CytronTechnologies/MAKER-UNO-X/Schematic and PCB/Gerber Files/MAKER-UNO-X.TXT

%
M48
M72
T01C0.01000
T02C0.01500
T03C0.01575
T04C0.02000
T05C0.03150
T06C0.03200
T07C0.03543
T08C0.03937
T09C0.11811
%
T01
X46500Y109500
X49500Y109500
X52500Y109500
X52500Y115500
X49500Y115500
X46500Y115500
X38500Y119500
X35500Y119500
X32500Y119500
X32500Y125500
X35500Y125500
X38500Y125500
X46500Y129500
X49500Y129500
X52500Y129500
X52500Y135500
X49500Y135500
X46500Y135500
X38500Y139500
X35500Y139500
X32500Y139500
X32500Y145500
X35500Y145500
X38500Y145500
X46500Y149500
X49500Y149500
X52500Y149500
X52500Y155500
X49500Y155500
X46500Y155500
X38500Y159500
X35500Y159500
X32500Y159500
X32500Y165500
X35500Y165500
X38500Y165500
X46500Y179500
X49500Y179500
X52500Y179500
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
