CytronTechnologies/MAKER-UNO-X/Schematic and PCB/Schematic - PDF/MAKER-UNO-X.pdf

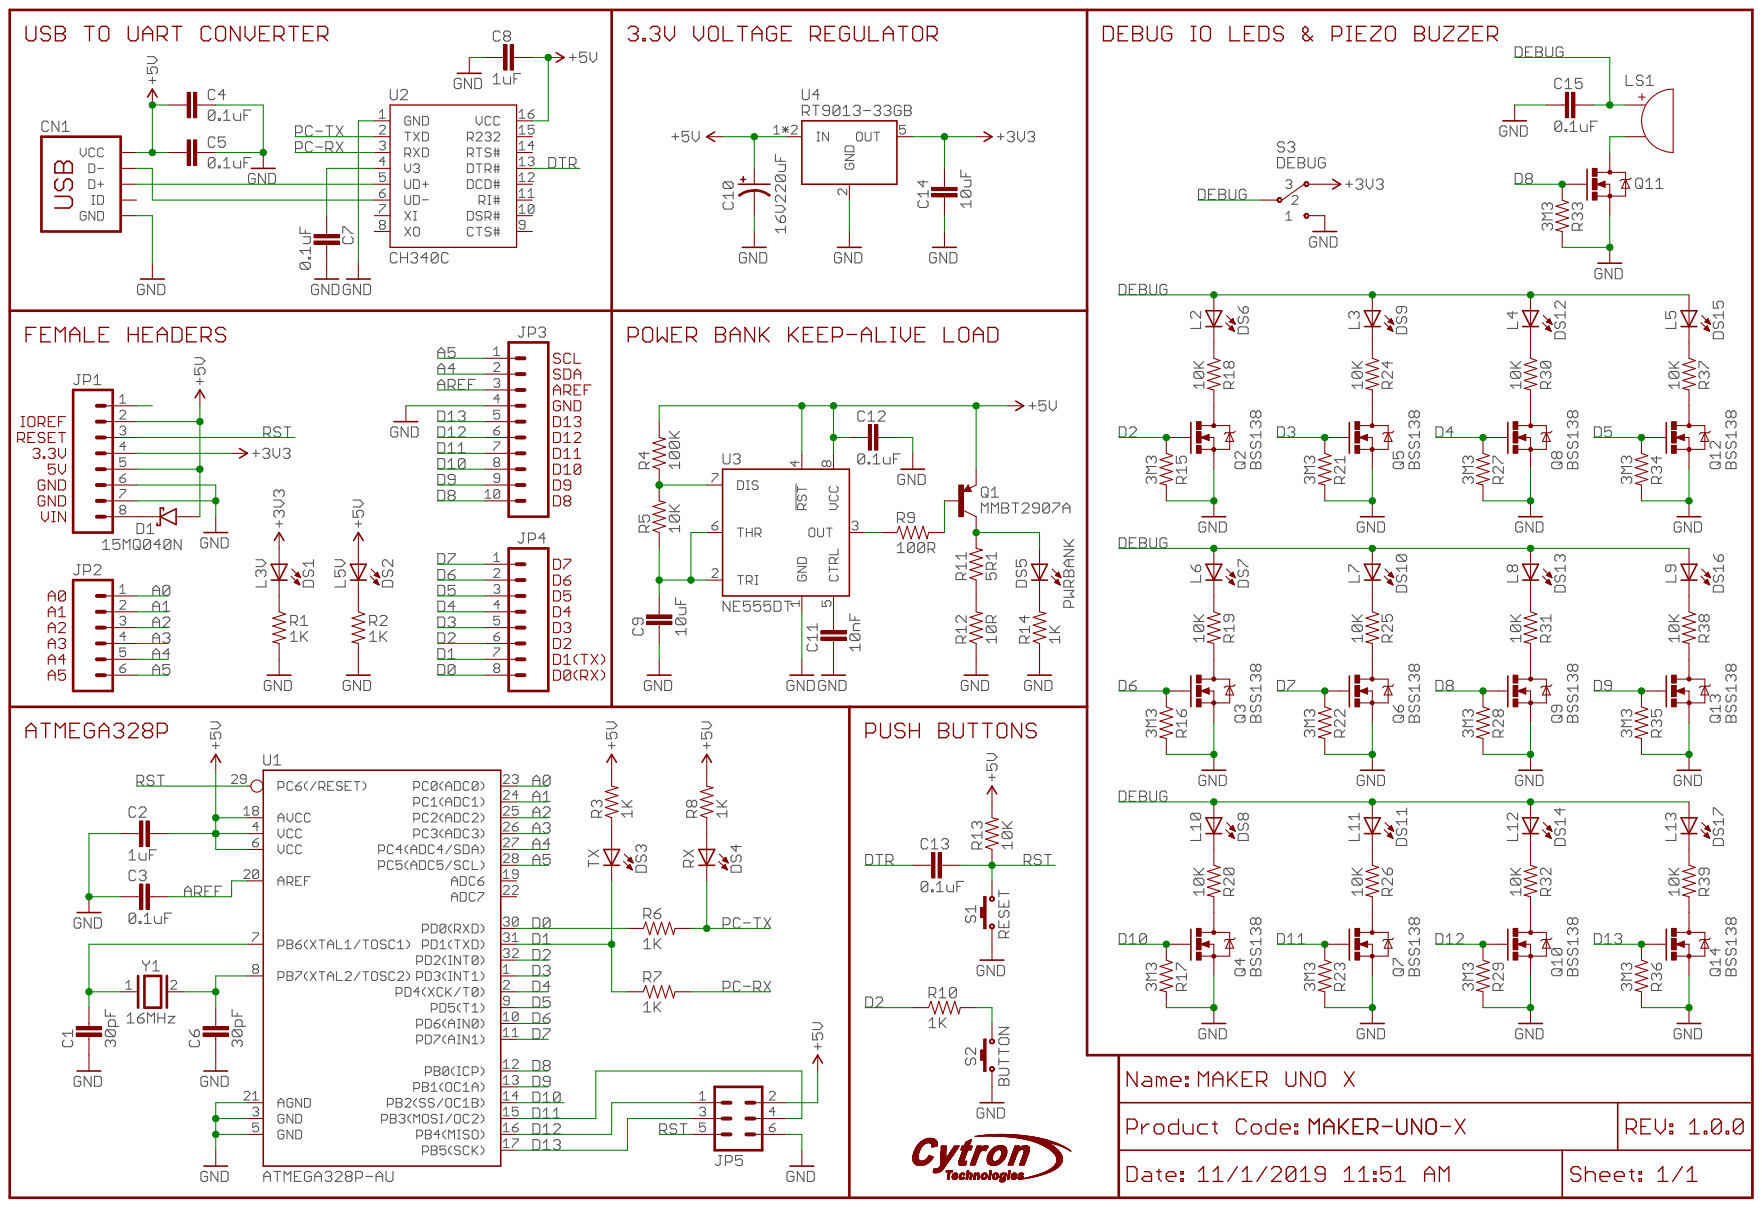
[picture p1: page 1]
