CytronTechnologies/MAKER-UNO-X/Schematic and PCB/Assembly Diagrams/Value - MAKER-UNO-X.pdf

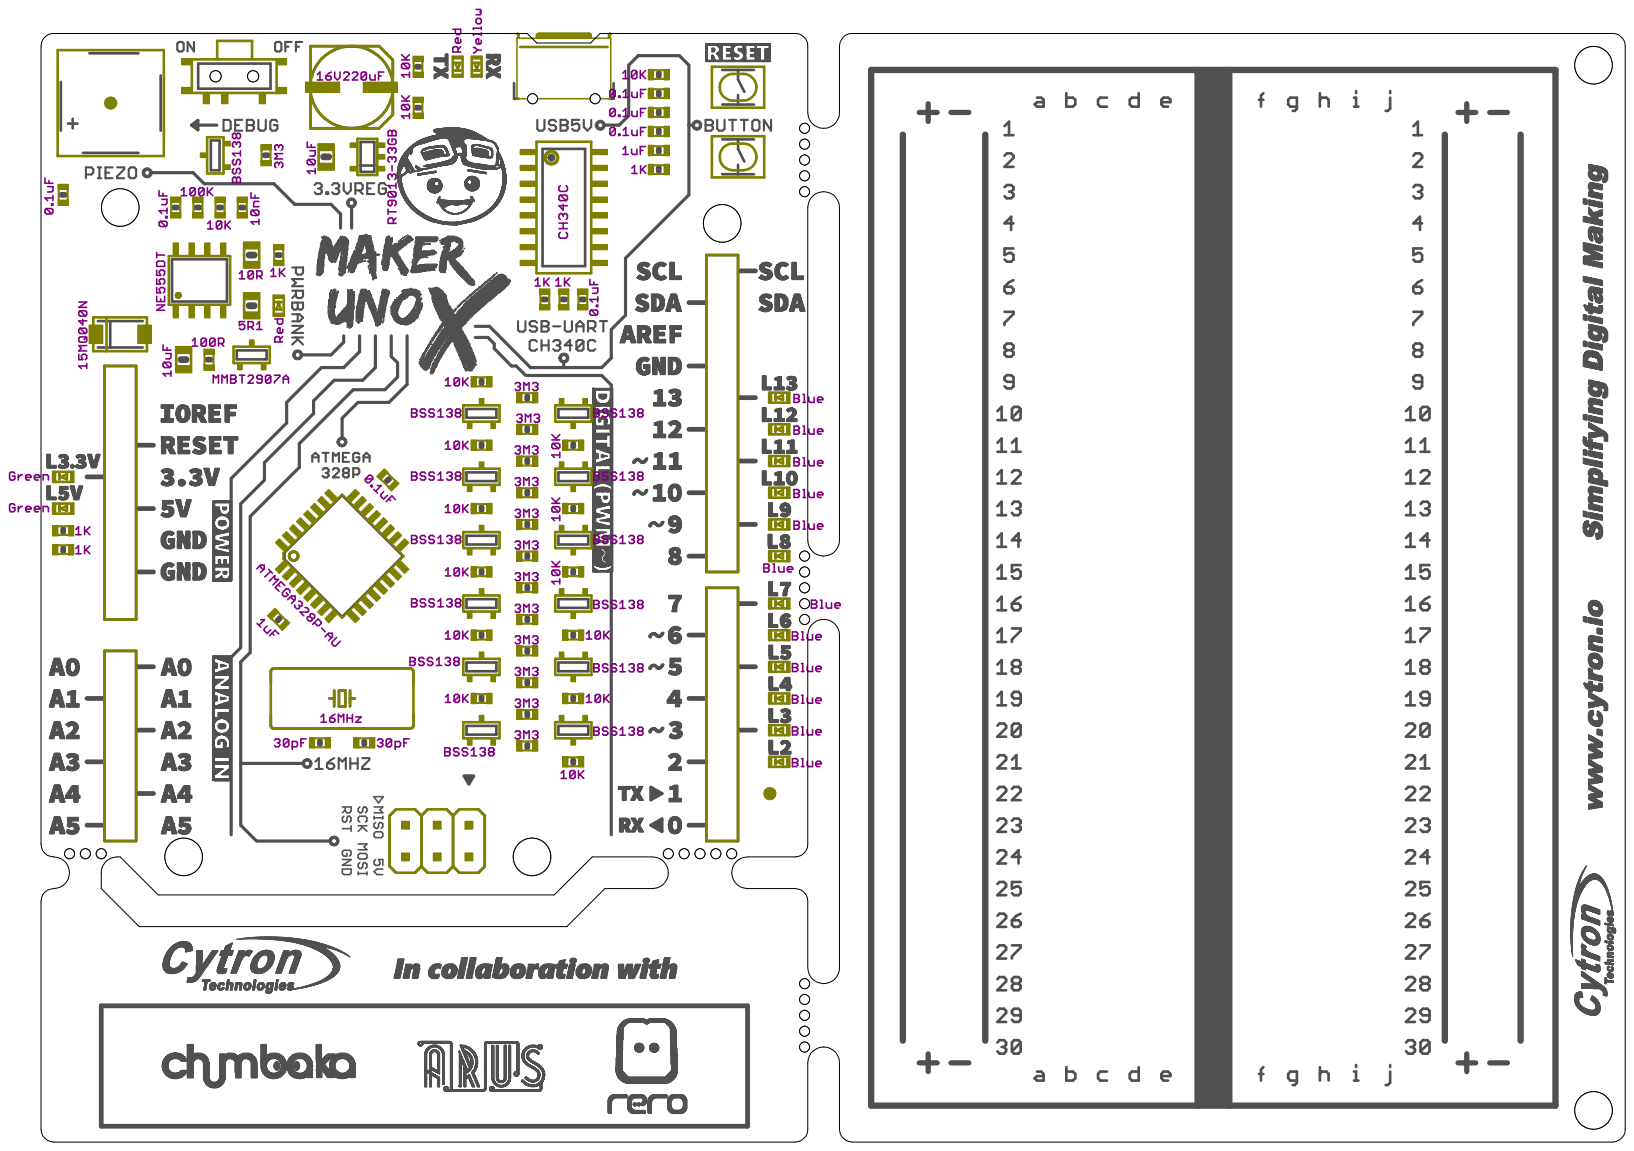
[picture p2: page 1]
