CytronTechnologies/MAKER-UNO-X/Schematic and PCB/Assembly Diagrams/Name - MAKER-UNO-X.pdf

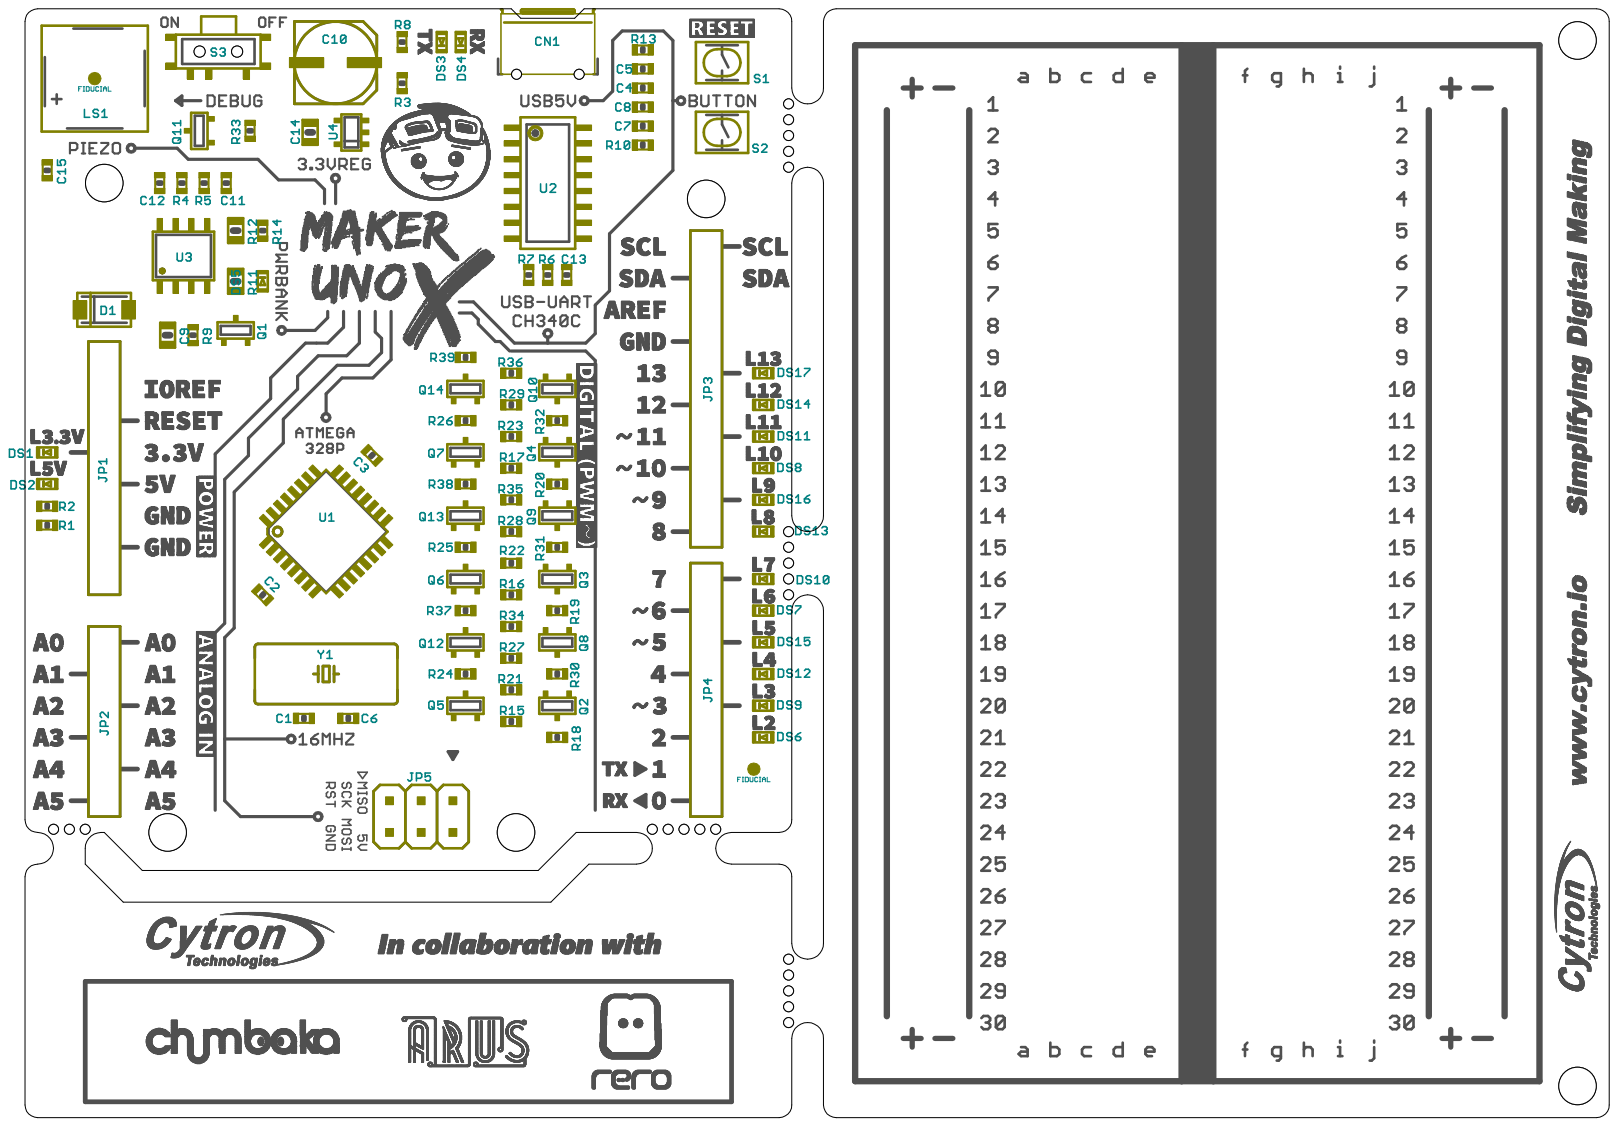
[picture p3: page 1]
