CytronTechnologies/MAKER-UNO-X/Schematic and PCB/Project/MAKER-UNO-X.sch

## EAGLE design Schematic and PCB/Project/MAKER-UNO-X.sch (2021-07-29)

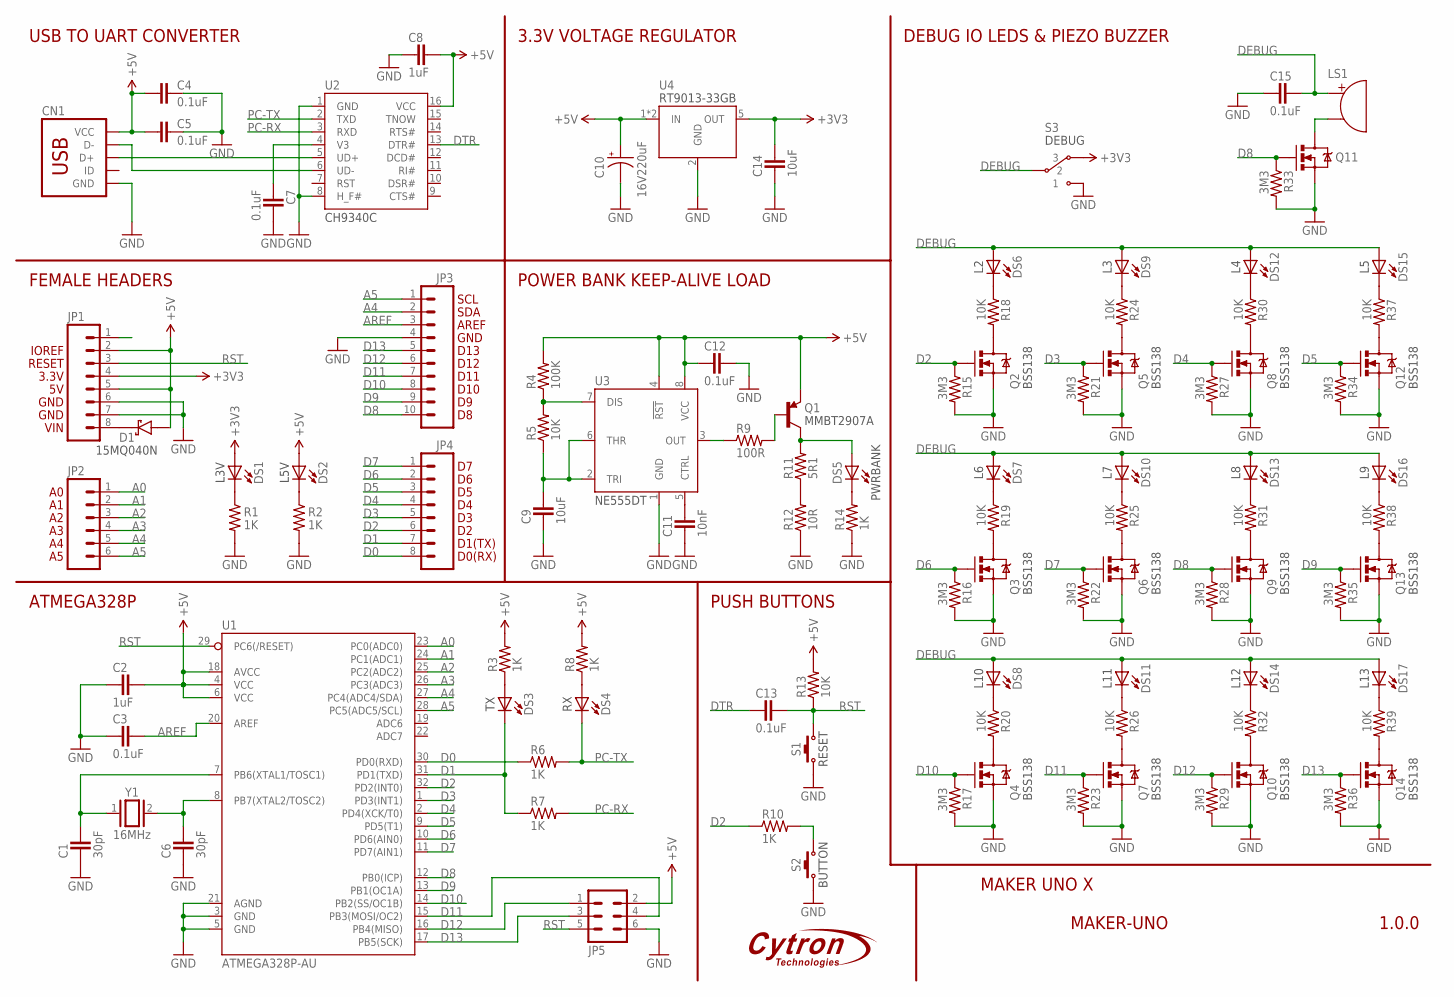
[picture p4: schematic MAKER-UNO-X.sch]

Parts:
C1, C6: 30pF; 1608
C2, C8: 1uF; 1608
C3, C4, C5, C7, C12, C13, C15: 0.1uF; 1608
C9, C14: 10uF; 2012
C10: 16V220uF; ECAP-CHEMICON-F
C11: 10nF; 1608
CN1: USB-5PIN_(MICRO-B-RA); USB-MICRO-B-REC
D1: 40V 3A; D-SMA
DS1, DS2: Green; LED-1608
DS3, DS5: Red; LED-1608
DS4: Yellow; LED-1608
DS6, DS7, DS8, DS9, DS10, DS11, DS12, DS13, DS14, DS15, DS16, DS17: Blue; LED-1608
JP1, JP4: 8 Ways; S-HDR-F1X08
JP2: 6 Ways; S-HDR-F1X06
JP3: 10 Ways; S-HDR-F1X10
JP5: 2x3 Ways; S-HDR-M2X03
LS1: BUZZER_(8530); S-BUZZER-HXD-8530A-03627
Q1: 60V 600mA; SOT-23
Q2, Q3, Q4, Q5, Q6, Q7, Q8, Q9, Q10, Q11, Q12, Q13, Q14: 50V 220mA; SOT-23
R1, R2, R3, R6, R7, R8, R10, R14: 1K; 1608
R4: 100K; 1608
R5, R13, R18, R19, R20, R24, R25, R26, R30, R31, R32, R37, R38, R39: 10K; 1608
R9: 100R; 1608
R11: 5R1; 2012
R12: 10R; 2012
R15, R16, R17, R21, R22, R23, R27, R28, R29, R33, R34, R35, R36: 3M3; 1608
S1, S2: SW-PB_(KAN3246); SW-PB-KAN3246
S3: SW-SLIDE-SPDT_(SMD); SW-SLIDE-SPDT-SMD
U1: ATMEGA328_SMT; TQFP-32-08
U2: CH9340C; SOIC-16N
U3: 555_(SOIC-08N); SOIC-08N
U4: 3.3V 500mA; SOT-23-5
Y1: 16MHz; XTAL-HC49UP

Connections:
+3V3: C14.1, DS1.A, JP1.4, S3.3, U4.5 (OUT)
+5V: C2.1, C4.1, C5.1, C8.1, C10.+, C12.2, CN1.VBUS1 (VCC), D1.A, DS2.A, JP1.2, JP1.5, JP5.2, Q1.2 (E), R3.2, R4.2, R8.2, R13.2, U1.4 (VCC), U1.6 (VCC), U1.18 (AVCC), U2.16 (VCC), U3.4 (!RST), U3.8 (VCC), U4.1 (IN)
A0: JP2.1, U1.23 (PC0(ADC0))
A1: JP2.2, U1.24 (PC1(ADC1))
A2: JP2.3, U1.25 (PC2(ADC2))
A3: JP2.4, U1.26 (PC3(ADC3))
A4: JP2.5, JP3.2, U1.27 (PC4(ADC4/SDA))
A5: JP2.6, JP3.1, U1.28 (PC5(ADC5/SCL))
AREF: C3.1, JP3.3, U1.20 (AREF)
D0: JP4.8, R6.1, U1.30 (PD0(RXD))
D1: DS3.C, JP4.7, R7.1, U1.31 (PD1(TXD))
D2: JP4.6, Q2.1 (G), R10.1, R15.1, U1.32 (PD2(INT0))
D3: JP4.5, Q5.1 (G), R21.1, U1.1 (PD3(INT1))
D4: JP4.4, Q8.1 (G), R27.1, U1.2 (PD4(XCK/T0))
D5: JP4.3, Q12.1 (G), R34.1, U1.9 (PD5(T1))
D6: JP4.2, Q3.1 (G), R16.1, U1.10 (PD6(AIN0))
D7: JP4.1, Q6.1 (G), R22.1, U1.11 (PD7(AIN1))
D8: JP3.10, Q9.1 (G), Q11.1 (G), R28.1, R33.1, U1.12 (PB0(ICP))
D9: JP3.9, Q13.1 (G), R35.1, U1.13 (PB1(OC1A))
D10: JP3.8, Q4.1 (G), R17.1, U1.14 (PB2(SS/OC1B))
D11: JP3.7, JP5.4, Q7.1 (G), R23.1, U1.15 (PB3(MOSI/OC2))
D12: JP3.6, JP5.1, Q10.1 (G), R29.1, U1.16 (PB4(MISO))
D13: JP3.5, JP5.3, Q14.1 (G), R36.1, U1.17 (PB5(SCK))
DEBUG: C15.1, DS6.A, DS7.A, DS8.A, DS9.A, DS10.A, DS11.A, DS12.A, DS13.A, DS14.A, DS15.A, DS16.A, DS17.A, LS1.+, S3.2
DTR: C13.2, U2.13 (DTR#)
GND: C1.2, C2.2, C3.2, C4.2, C5.2, C6.2, C7.1, C8.2, C9.2, C10.-, C11.2, C12.1, C14.2, C15.2, CN1.GND1 (GND), JP1.6, JP1.7, JP3.4, JP5.6, Q2.2 (S), Q3.2 (S), Q4.2 (S), Q5.2 (S), Q6.2 (S), Q7.2 (S), Q8.2 (S), Q9.2 (S), Q10.2 (S), Q11.2 (S), Q12.2 (S), Q13.2 (S), Q14.2 (S), R1.2, R2.2, R12.1, R14.1, R15.2, R16.2, R17.2, R21.2, R22.2, R23.2, R27.2, R28.2, R29.2, R33.2, R34.2, R35.2, R36.2, S1.1, S2.1, S3.1, U1.3 (GND), U1.5 (GND), U1.21 (AGND), U2.1 (GND), U2.8 (H_F#), U3.1 (GND), U4.2 (GND)
L2: Q2.3 (D), R18.2
L3: Q5.3 (D), R24.2
L4: Q8.3 (D), R30.2
L5: Q12.3 (D), R37.2
L6: Q3.3 (D), R19.2
L7: Q6.3 (D), R25.2
L8: Q9.3 (D), R31.2
L9: Q13.3 (D), R38.2
L10: Q4.3 (D), R20.2
L11: Q7.3 (D), R26.2
L12: Q10.3 (D), R32.2
L13: Q14.3 (D), R39.2
unnamed: C11.1, U3.5 (CTRL)
unnamed: DS5.C, R14.2
unnamed: C7.2, U2.4 (V3)
unnamed: C6.1, U1.8 (PB7(XTAL2/TOSC2)), Y1.2
unnamed: C1.1, U1.7 (PB6(XTAL1/TOSC1)), Y1.1
unnamed: DS3.A, R3.1
unnamed: DS4.A, R8.1
unnamed: R9.1, U3.3 (OUT)
unnamed: DS17.C, R39.1
unnamed: DS15.C, R37.1
unnamed: Q1.1 (B), R9.2
unnamed: C9.1, R5.1, U3.2 (TRI), U3.6 (THR)
unnamed: R4.1, R5.2, U3.7 (DIS)
unnamed: DS5.A, Q1.3 (C), R11.2
unnamed: R11.1, R12.2
unnamed: DS2.C, R2.1
unnamed: DS1.C, R1.1
unnamed: LS1.-, Q11.3 (D)
unnamed: R10.2, S2.3 (2)
unnamed: DS6.C, R18.1
unnamed: DS9.C, R24.1
unnamed: DS12.C, R30.1
unnamed: DS7.C, R19.1
unnamed: DS10.C, R25.1
unnamed: DS13.C, R31.1
unnamed: DS16.C, R38.1
unnamed: DS8.C, R20.1
unnamed: DS11.C, R26.1
unnamed: DS14.C, R32.1
PC-RX: R7.2, U2.3 (RXD)
PC-TX: DS4.C, R6.2, U2.2 (TXD)
RST: C13.1, JP1.3, JP5.5, R13.1, S1.3 (2), U1.29 (PC6(/RESET))
USB+: CN1.D+1 (D+), U2.5 (UD+)
USB-: CN1.D-1 (D-), U2.6 (UD-)
VIN: D1.C, JP1.8

Notes on the sheet:
MAKER UNO X
MAKER-UNO
1.0.0
DEBUG IO LEDS & PIEZO BUZZER
ATMEGA328P
PUSH BUTTONS
USB TO UART CONVERTER
3.3V VOLTAGE REGULATOR
POWER BANK KEEP-ALIVE LOAD
FEMALE HEADERS
IOREF
RESET
3.3V
GND
VIN
SCL
SDA
AREF
D13
D12
D11
D10
D1(TX)
D0(RX)
