CytronTechnologies/MAKER-UNO-X/(commit log)

2019-10-10 Initial commit.
    [MAKER-UNO-X.sch]
2019-10-15 Modified the overlay.
    [MAKER-UNO-X.sch]
2019-10-17 Prototype 1.
    [MAKER-UNO-X.GBL, MAKER-UNO-X.GBO, MAKER-UNO-X.GBP, MAKER-UNO-X.GBS, MAKER-UNO-X.GTL, MAKER-UNO-X.GTO, MAKER-UNO-X.GTP, MAKER-UNO-X.GTS]
2019-10-17 Added assembly diagrams.
    [MAKER-UNO-X.sch]
2019-10-30 Updated resistor value.
    [MAKER-UNO-X.sch]
2019-11-14 Fixed the problem of the debug switch and strengthen the mouse bite.
    [MAKER-UNO-X.GBL, MAKER-UNO-X.GBO, MAKER-UNO-X.GBP, MAKER-UNO-X.GBS, MAKER-UNO-X.GTL, MAKER-UNO-X.GTO, MAKER-UNO-X.GTP, MAKER-UNO-X.GTS]
2019-11-14 Fixed the problem of the debug switch.
2019-12-19 Final version for production.
    [MAKER-UNO-X.GBL, MAKER-UNO-X.GBO, MAKER-UNO-X.GBP, MAKER-UNO-X.GBS, MAKER-UNO-X.GTL, MAKER-UNO-X.GTO, MAKER-UNO-X.GTP, MAKER-UNO-X.GTS]
2020-01-17 Set Debug switch to Off by default
2021-07-29 Replaced CH340C with CH9340C.
    [MAKER-UNO-X.sch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]
